RileyCornelius/LedCube-RGB/README.md

# LedCube
RGB Led Cube controlled by FastLED

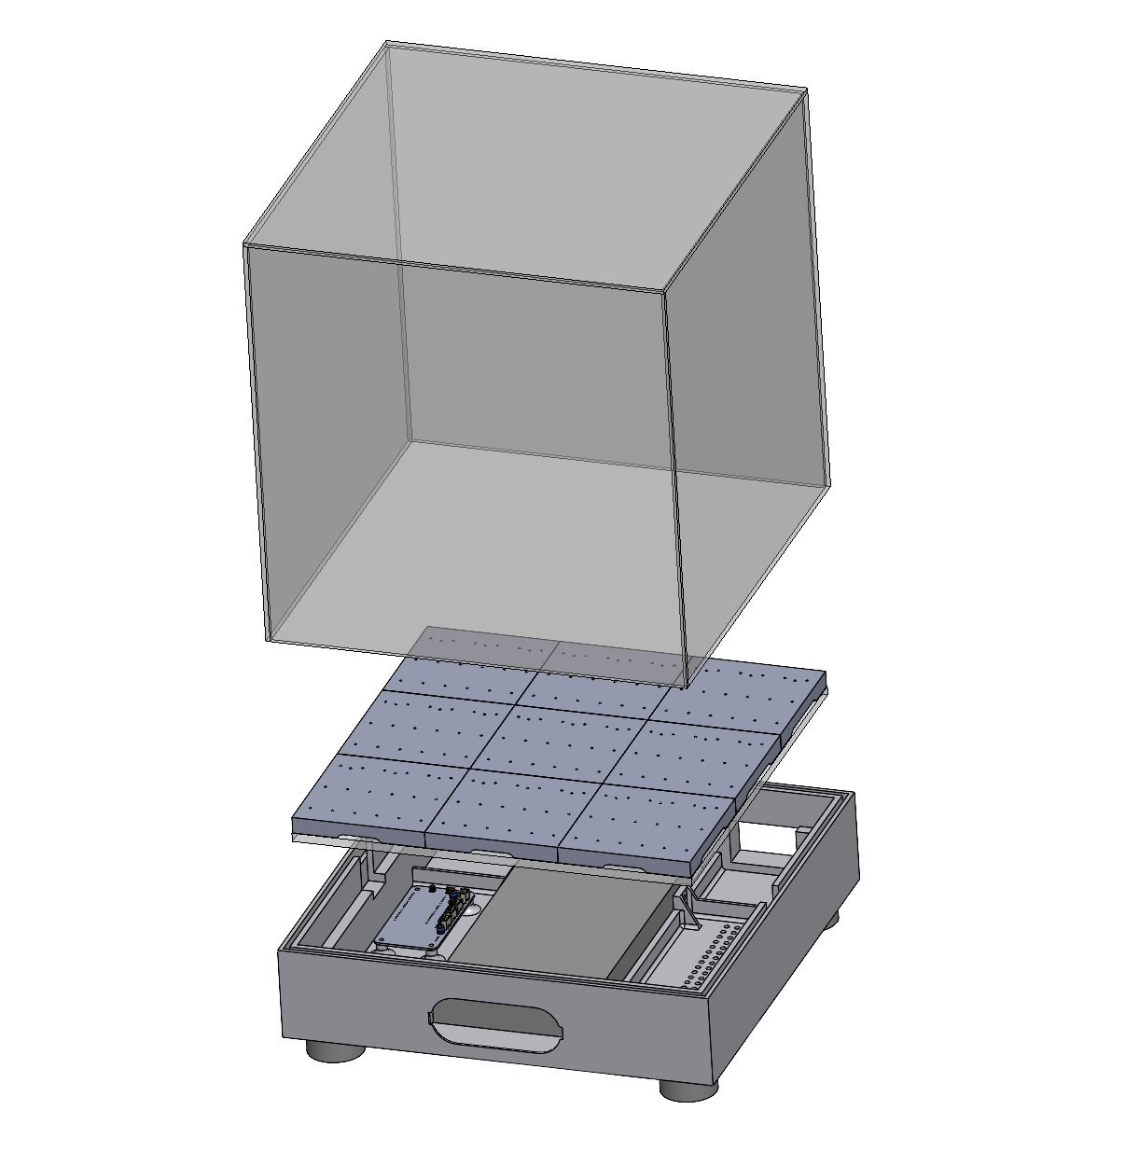
[picture p1: mechanical/Case-Parts-Assembly.png]
Drag Racing
