RileyCornelius/LedCube-RGB/electronics/block diagram/LedCube block diagram,.png

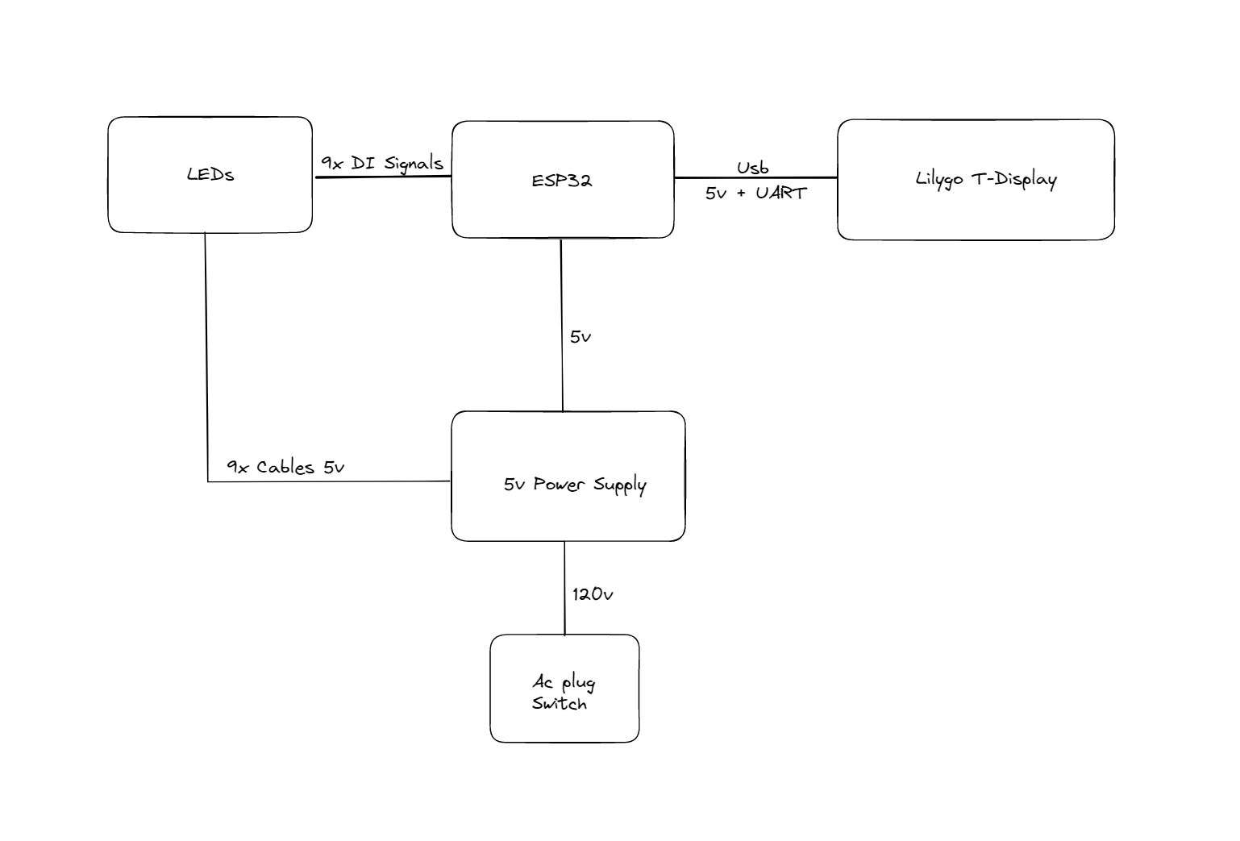
electronics/block diagram/LedCube block diagram,.png
