RileyCornelius/LedCube-RGB/electronics/kicad/PCB.png

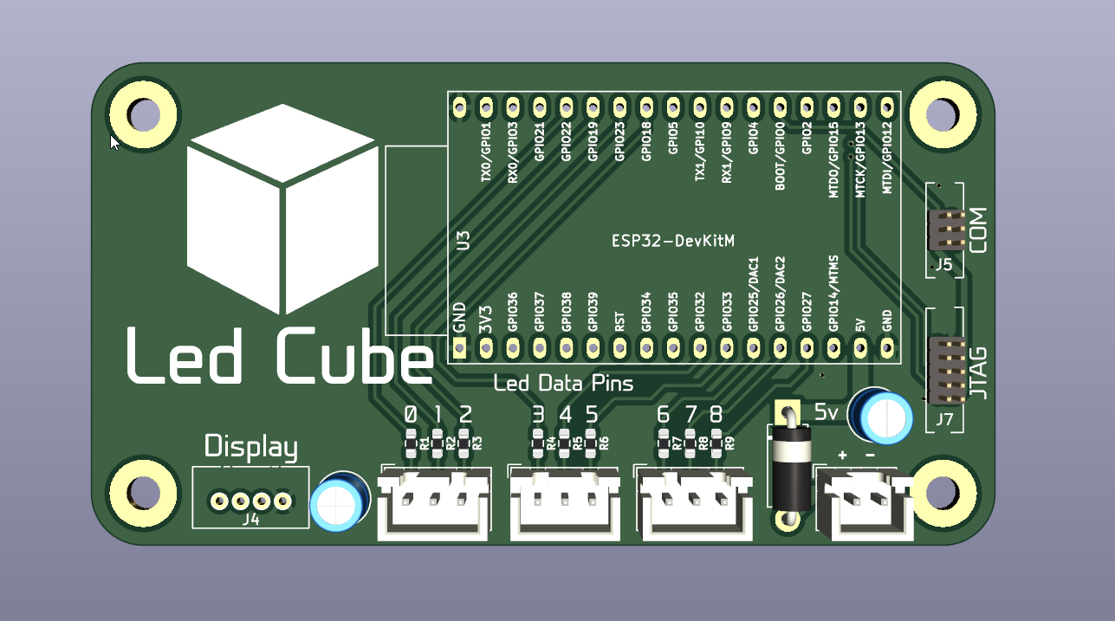
electronics/kicad/PCB.png
