RileyCornelius/LedCube-RGB/mechanical/case/solidworks/Case Full.SLDPRT

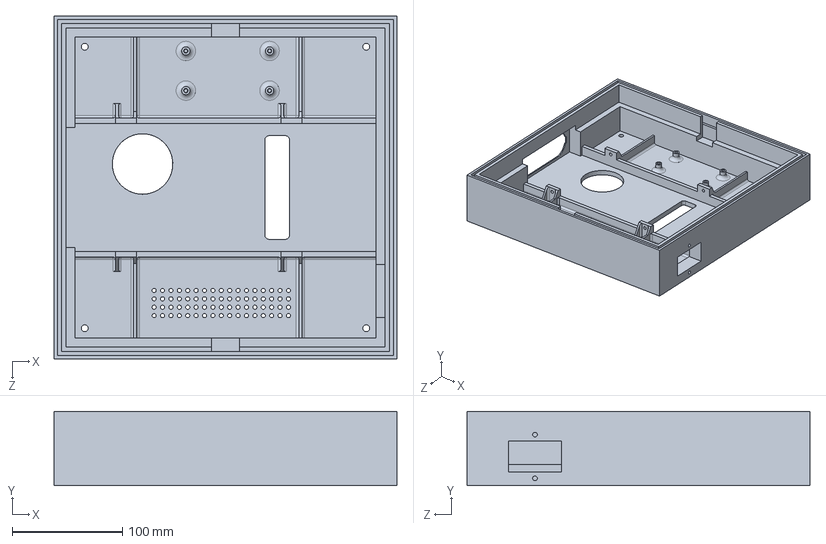
[picture p4: CAD file, 2023-04-22]
mechanical/case/solidworks/Case Full.SLDPRT
311.4 x 67.3 x 311.4 mm
