RileyCornelius/LedCube-RGB/mechanical/case/solidworks/Assem Led Base.SLDASM

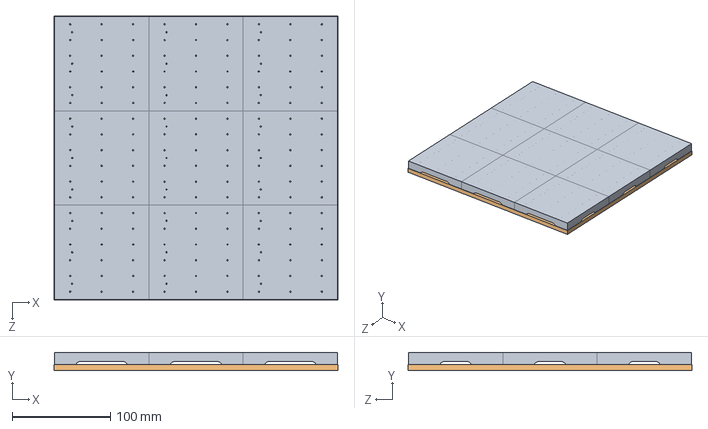
[picture p5: CAD file, 2023-04-22]
mechanical/case/solidworks/Assem Led Base.SLDASM
288.9 x 18.4 x 288.9 mm
Mounting Base x 9
Plexiglass11.4x11.4x1-4inch
