RileyCornelius/LedCube-RGB/mechanical/case/solidworks/Assem Corner Case.SLDASM

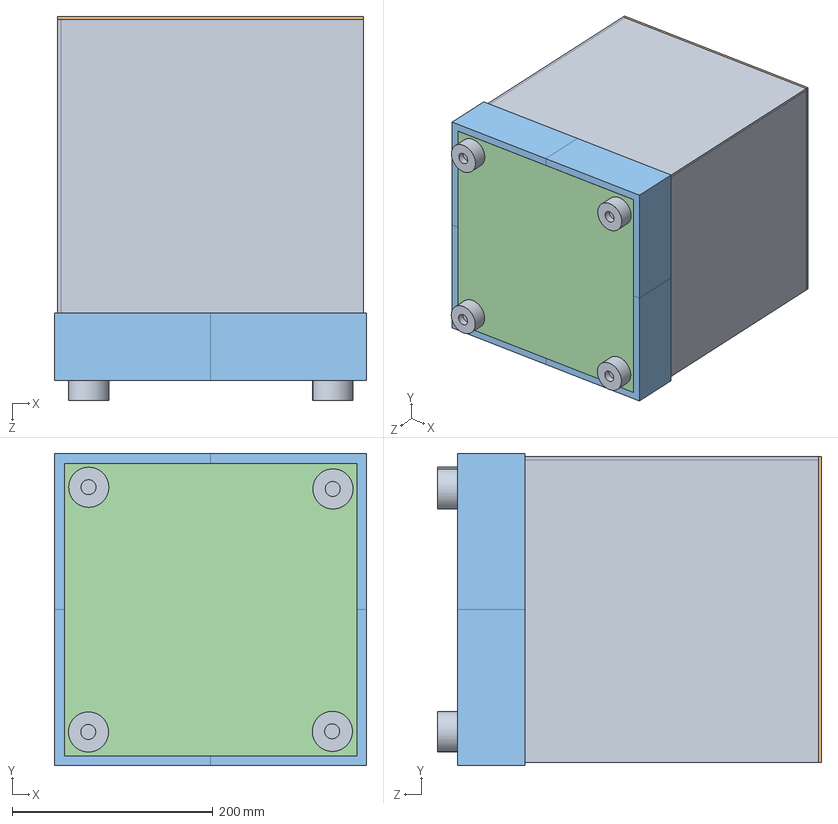
[picture p6: CAD file, 2023-04-22]
mechanical/case/solidworks/Assem Corner Case.SLDASM
311.4 x 311.4 x 382.7 mm
Plexiglass12x12x1-8inch
Plexiglass12x11 7-8x1-8inch x 4
Case Corner x 4
Plexiglass11.5x11.5x1-4inch
Plexiglass11.4x11.4x1-4inch
Mounting Base x 9
LED Height 1x11 1-2x1-4inch
Power Supply
Feet x 4
