RileyCornelius/LedCube-RGB/mechanical/case/solidworks/Assem Full Case.SLDASM

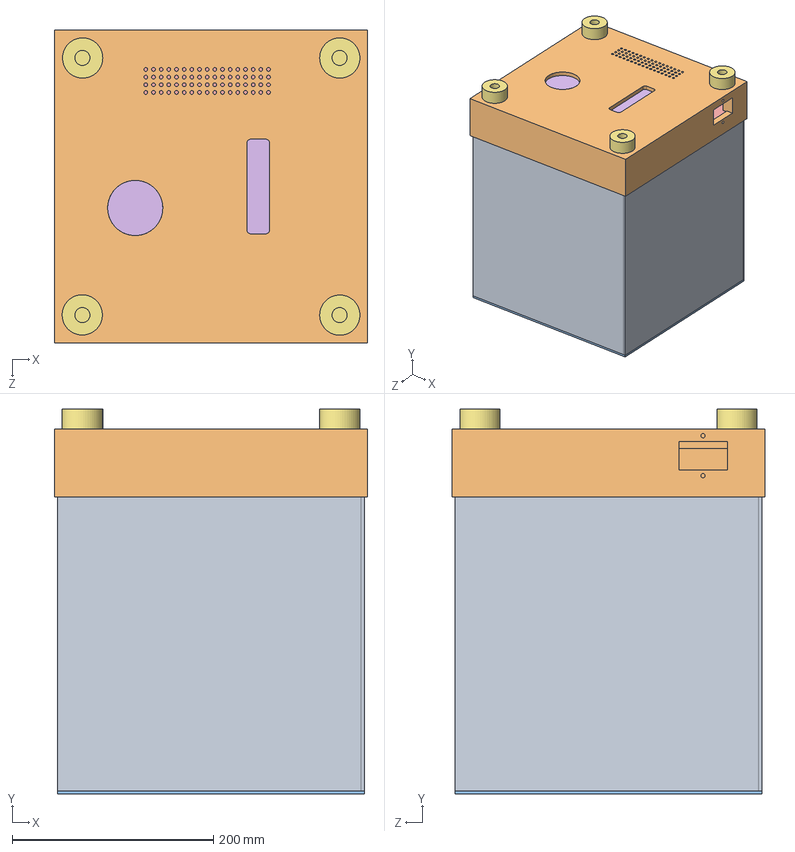
[picture p7: CAD file, 2023-04-22]
mechanical/case/solidworks/Assem Full Case.SLDASM
311.4 x 382.6 x 311.4 mm
Case Full
Plexiglass12x12x1-8inch
Plexiglass12x11 7-8x1-8inch x 4
Mounting Base x 9
Plexiglass11.4x11.4x1-4inch
Power Supply
Feet x 4
SOLID.step x 2
SOLID-0.step x 9
SOLID-1.step
SOLID-2.step x 3
SOLID-3.step
SOLID-4.step
SOLID-5.step
_autosave-LedCube PCB.step
