RileyCornelius/LedCube-RGB/mechanical/case/solidworks/Assem Plexiglass .SLDASM

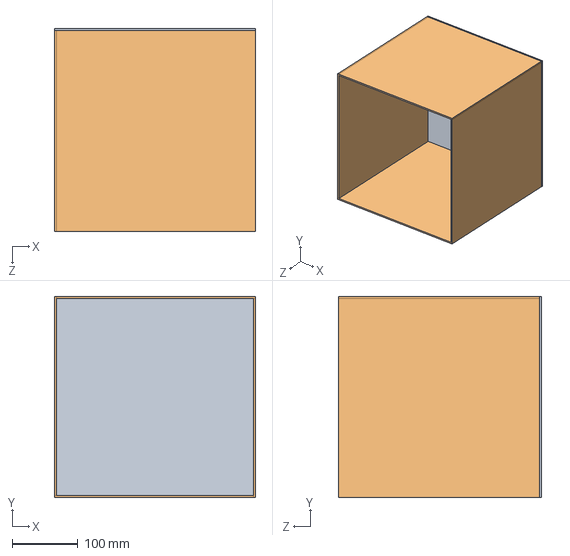
[picture p8: CAD file, 2023-04-22]
mechanical/case/solidworks/Assem Plexiglass .SLDASM
304.8 x 304.8 x 308.0 mm
Plexiglass12x12x1-8inch
Plexiglass12x11 7-8x1-8inch x 4
