RileyCornelius/LedCube-RGB/mechanical/accessories/solidworks/Jig Bottom B.SLDPRT

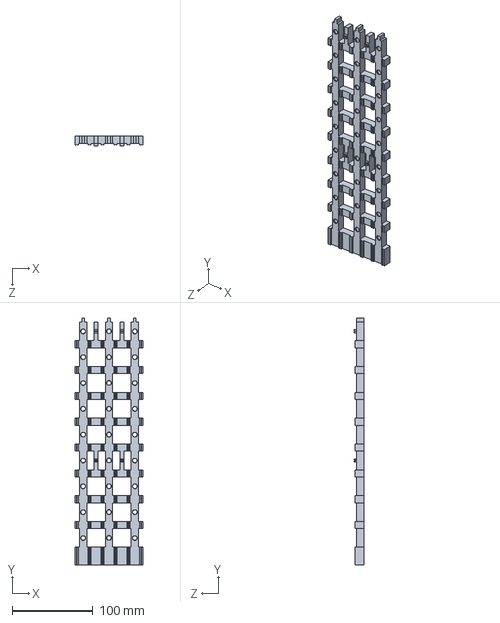
[picture p9: CAD file, 2023-03-17]
mechanical/accessories/solidworks/Jig Bottom B.SLDPRT
84.0 x 306.0 x 11.9 mm
