RileyCornelius/LedCube-RGB/mechanical/accessories/stl/Clip.stl

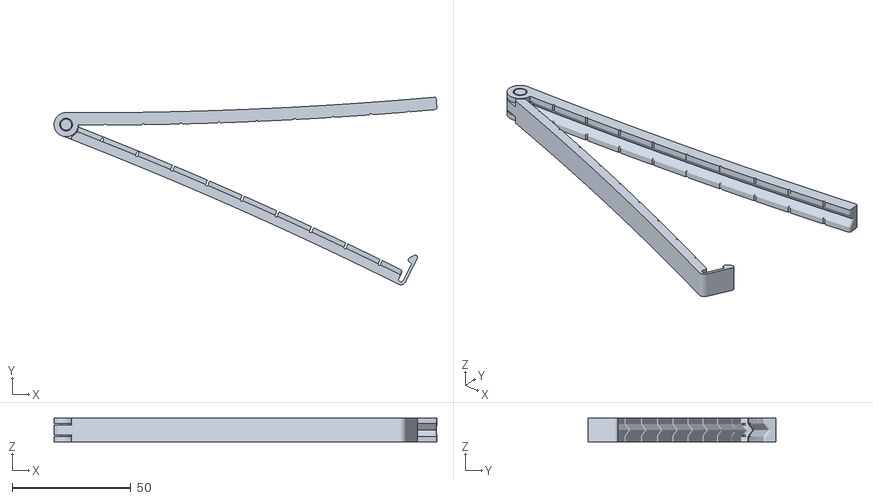
[picture p10: CAD file, 2023-03-17]
mechanical/accessories/stl/Clip.stl
161.5 x 79.1 x 10.0
