RileyCornelius/LedCube-RGB/mechanical/case/stl/display-front-panel.stl

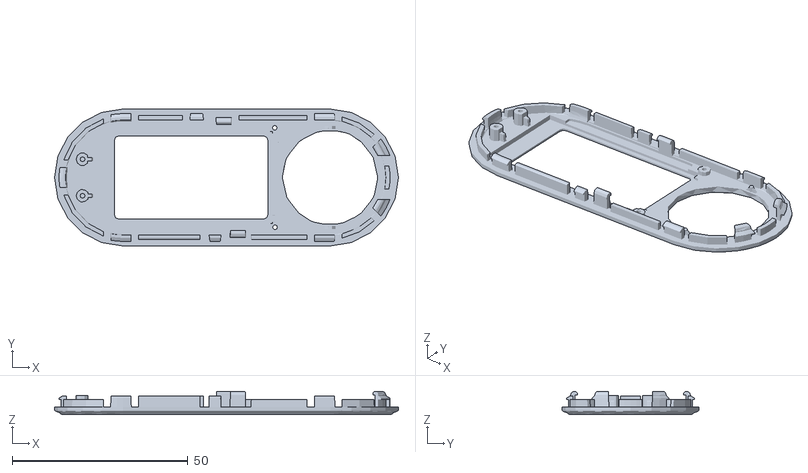
[picture p11: CAD file, 2023-03-17]
mechanical/case/stl/display-front-panel.stl
98.0 x 39.0 x 6.60
