RileyCornelius/LedCube-RGB/mechanical/accessories/stl/BendBox.stl

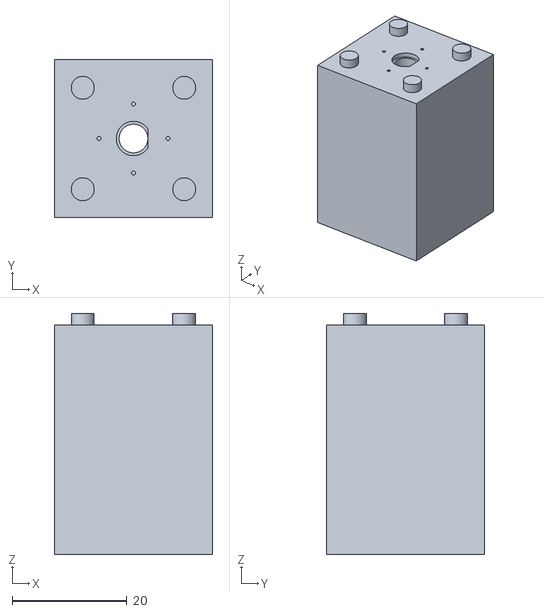
[picture p12: CAD file, 2023-03-17]
mechanical/accessories/stl/BendBox.stl
27.6 x 27.6 x 42.0
