RileyCornelius/LedCube-RGB/mechanical/case/solidworks/Mounting Base.SLDPRT

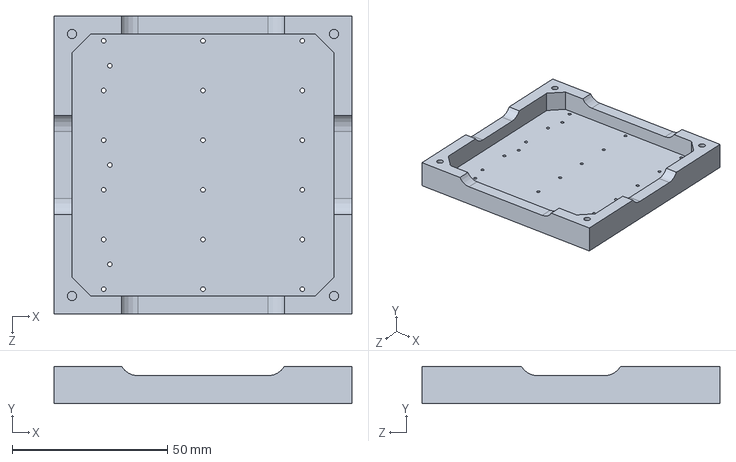
[picture p13: CAD file, 2023-04-22]
mechanical/case/solidworks/Mounting Base.SLDPRT
96.0 x 12.0 x 96.0 mm
