RileyCornelius/LedCube-RGB/mechanical/accessories/stl/BendBox Lid Thicker.stl

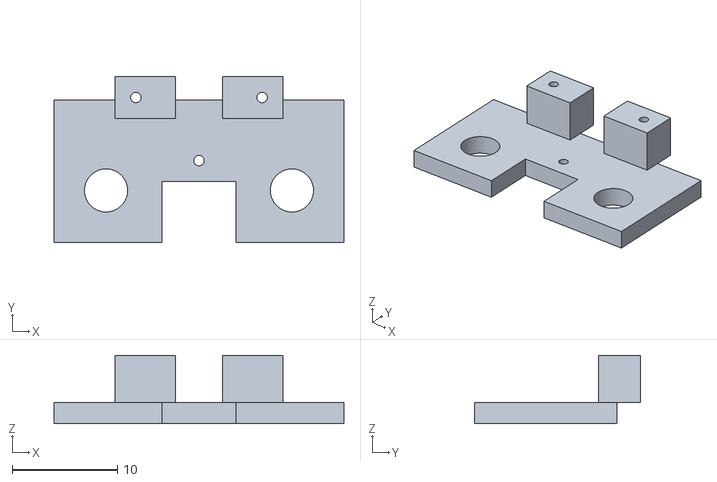
[picture p14: CAD file, 2023-03-17]
mechanical/accessories/stl/BendBox Lid Thicker.stl
27.6 x 15.8 x 6.50
