RileyCornelius/LedCube-RGB/mechanical/accessories/stl/BendBox Lid Flat.stl

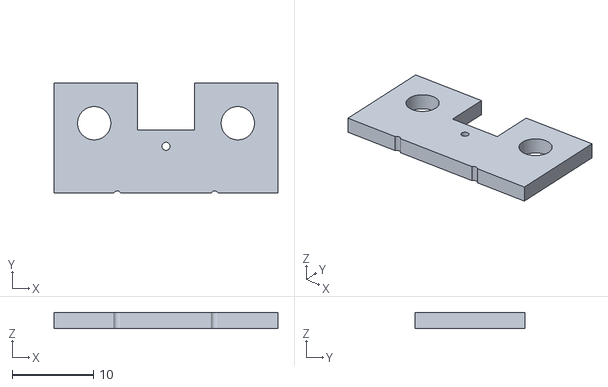
[picture p15: CAD file, 2023-03-17]
mechanical/accessories/stl/BendBox Lid Flat.stl
27.6 x 13.5 x 2.00
