RileyCornelius/LedCube-RGB/mechanical/case/solidworks/Power Supply.SLDPRT

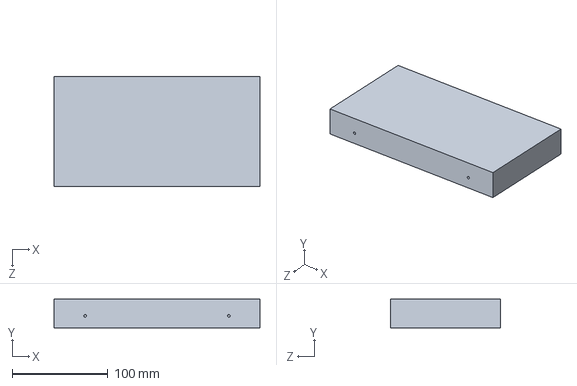
[picture p16: CAD file, 2023-04-22]
mechanical/case/solidworks/Power Supply.SLDPRT
215.0 x 30.0 x 115.0 mm
