RileyCornelius/LedCube-RGB/mechanical/case/solidworks/screen mount.SLDPRT

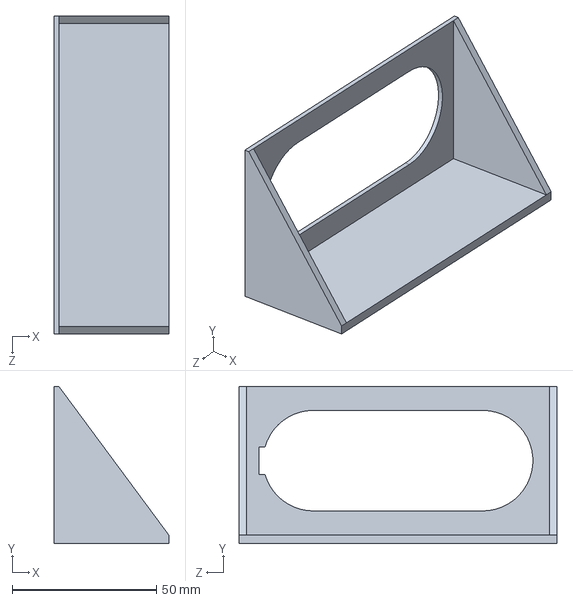
[picture p17: CAD file, 2023-04-22]
mechanical/case/solidworks/screen mount.SLDPRT
39.7 x 54.5 x 110.1 mm
