RileyCornelius/LedCube-RGB/mechanical/case/solidworks/Plexiglass11.4x11.4x1-4inch.SLDPRT

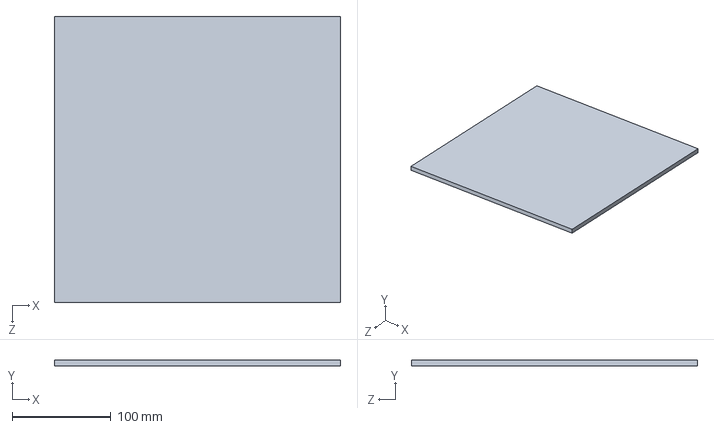
[picture p18: CAD file, 2023-04-22]
mechanical/case/solidworks/Plexiglass11.4x11.4x1-4inch.SLDPRT
288.9 x 6.36 x 288.9 mm
