RileyCornelius/LedCube-RGB/mechanical/case/solidworks/LedCubePCB.step

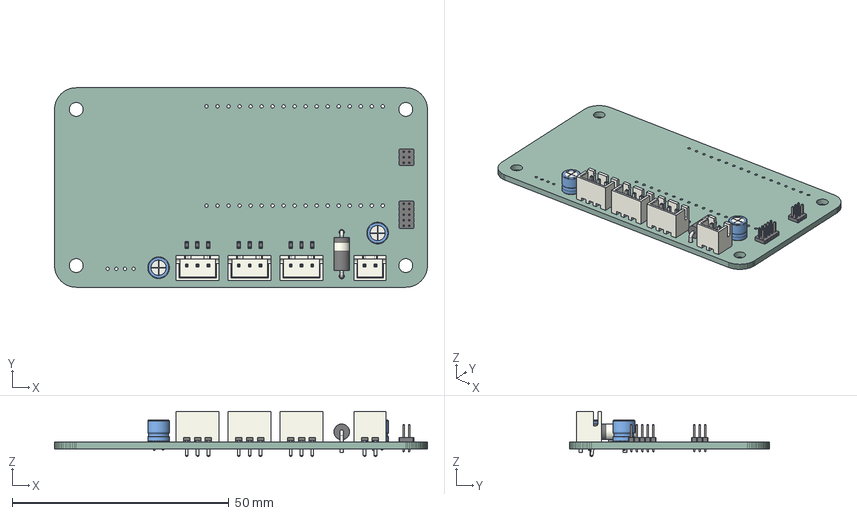
[picture p19: CAD file, 2023-04-21]
mechanical/case/solidworks/LedCubePCB.step
86.0 x 46.0 x 10.4 mm
_autosave-LedCube PCB
