RileyCornelius/LedCube-RGB/mechanical/case/solidworks/Case Corner.SLDPRT

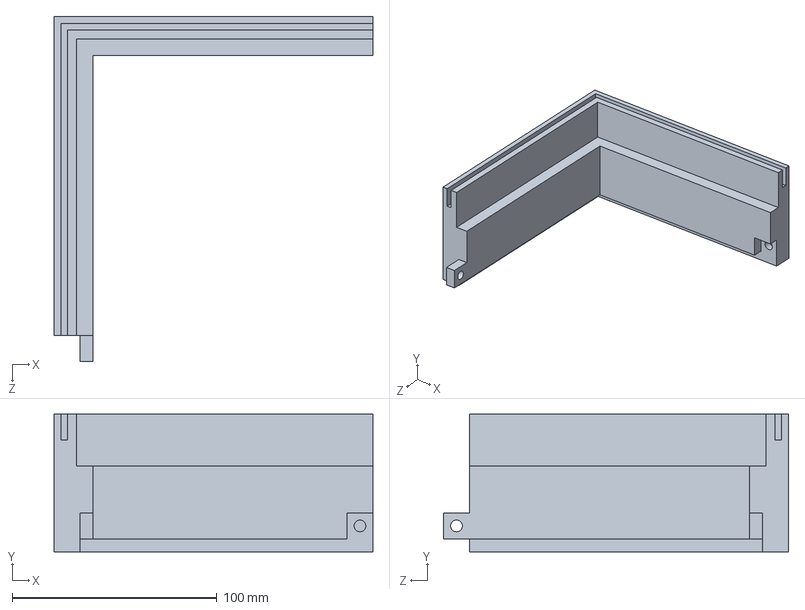
[picture p20: CAD file, 2023-04-04]
mechanical/case/solidworks/Case Corner.SLDPRT
155.7 x 67.3 x 168.4 mm
