RileyCornelius/LedCube-RGB/mechanical/case/solidworks/Plexiglass12x12x1-8inch.SLDPRT

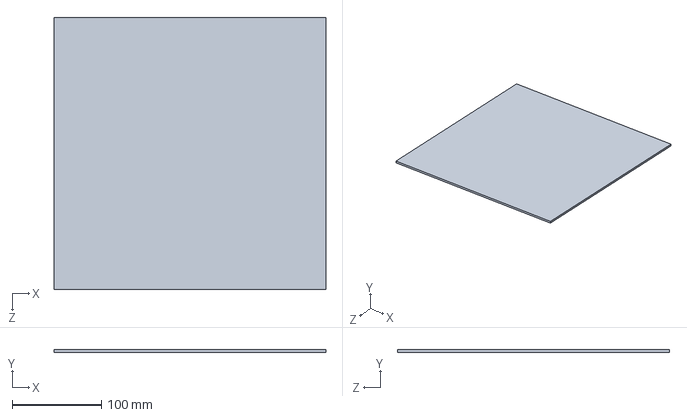
[picture p21: CAD file, 2023-03-17]
mechanical/case/solidworks/Plexiglass12x12x1-8inch.SLDPRT
304.8 x 3.17 x 304.8 mm
