RileyCornelius/LedCube-RGB/mechanical/case/solidworks/LED Height 1x11 1-2x1-4inch.SLDPRT

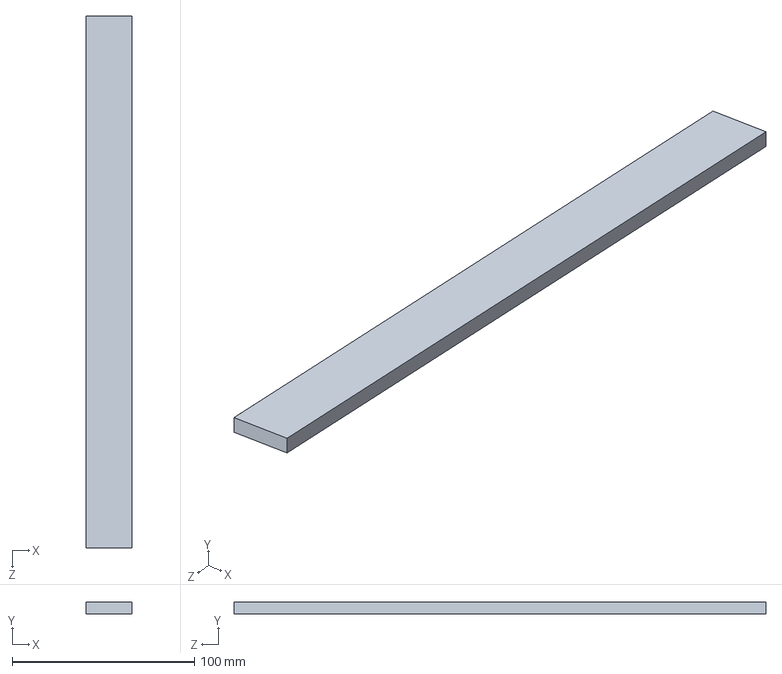
[picture p22: CAD file, 2023-03-17]
mechanical/case/solidworks/LED Height 1x11 1-2x1-4inch.SLDPRT
25.3 x 6.36 x 292.3 mm
