RileyCornelius/LedCube-RGB/mechanical/case/solidworks/Plexiglass11.5x11.5x1-4inch.SLDPRT

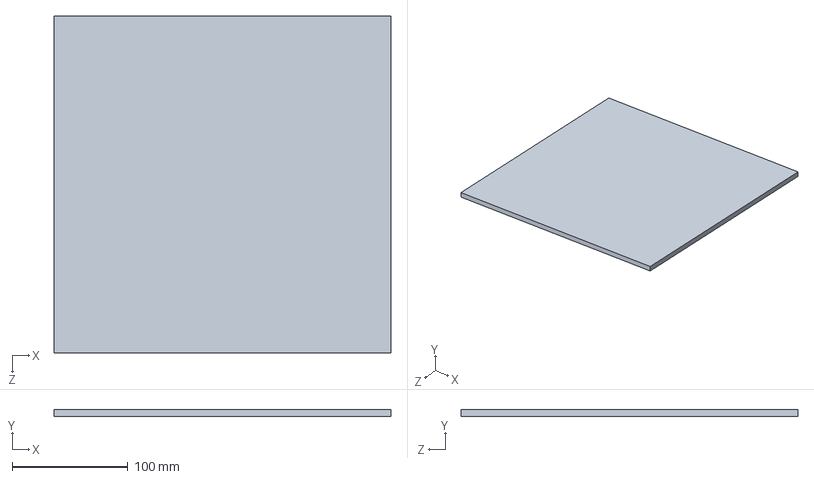
[picture p23: CAD file, 2023-03-17]
mechanical/case/solidworks/Plexiglass11.5x11.5x1-4inch.SLDPRT
291.7 x 6.36 x 291.7 mm
