RileyCornelius/LedCube-RGB/mechanical/case/solidworks/Feet Small.SLDPRT

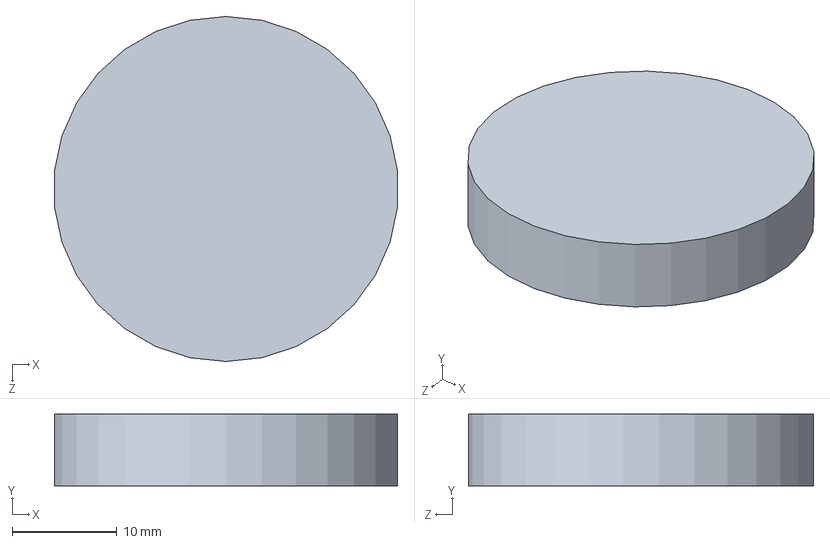
[picture p24: CAD file, 2023-03-17]
mechanical/case/solidworks/Feet Small.SLDPRT
32.8 x 6.86 x 33.0 mm
