RileyCornelius/LedCube-RGB/mechanical/case/solidworks/Feet.SLDPRT

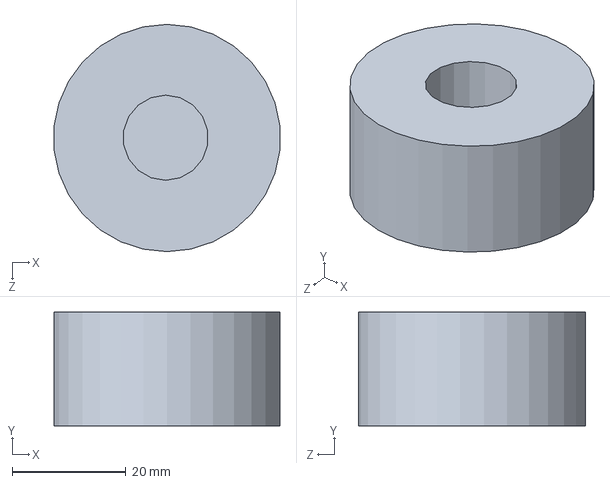
[picture p25: CAD file, 2023-03-17]
mechanical/case/solidworks/Feet.SLDPRT
39.8 x 20.0 x 40.0 mm
