RileyCornelius/LedCube-RGB/(list of files, cad)

Other CAD files:
mechanical/accessories/solidworks/Jig Bottom A.SLDPRT
mechanical/case/solidworks/Plexiglass12x11 7-8x1-8inch.SLDPRT
mechanical/case/stl/Case Full.STL
