RileyCornelius/LedCube-RGB/mechanical/Case-Assembly.png

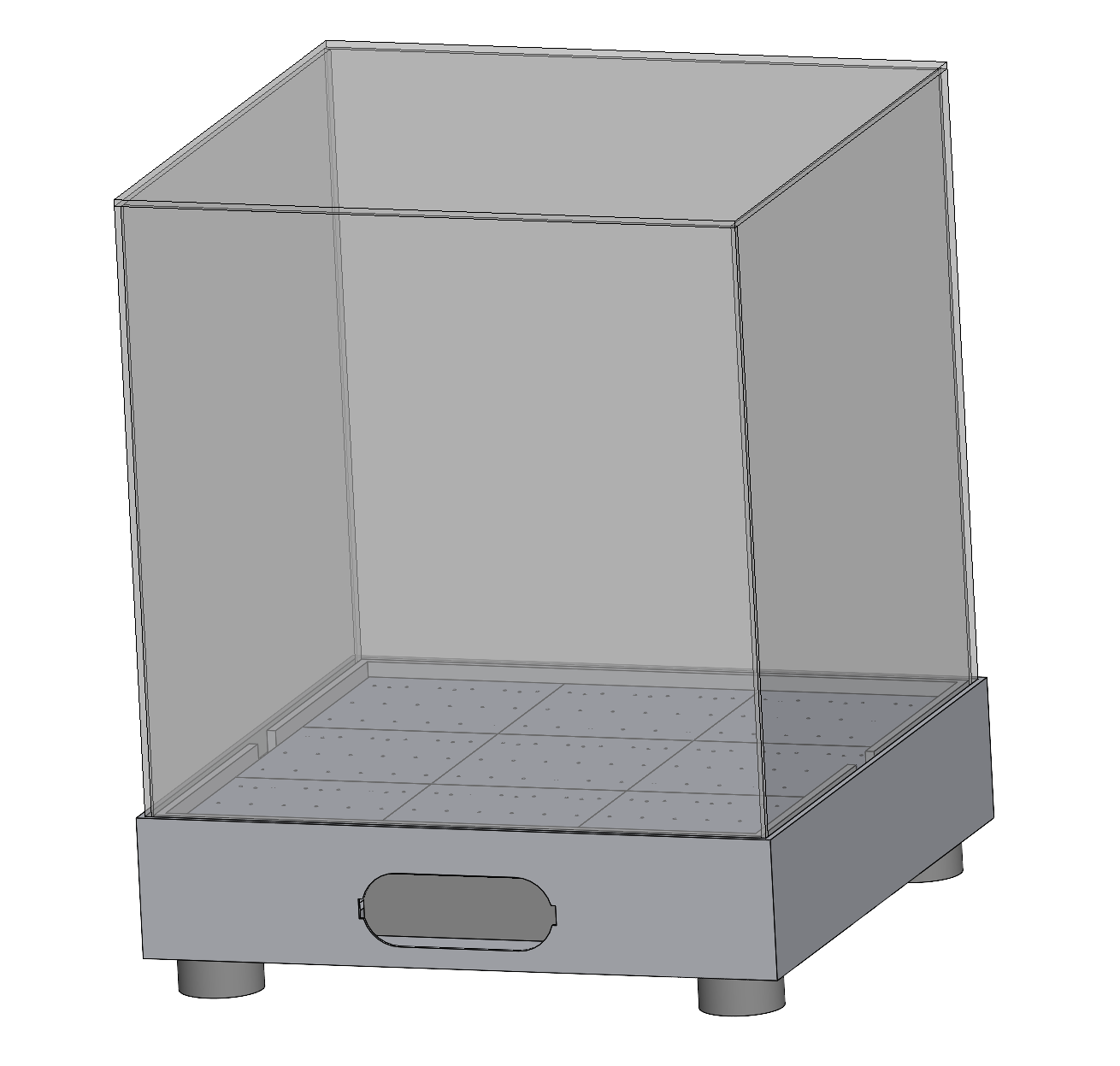
mechanical/Case-Assembly.png
