RileyCornelius/LedCube-RGB/mechanical/Case-Inside-Assembly.png

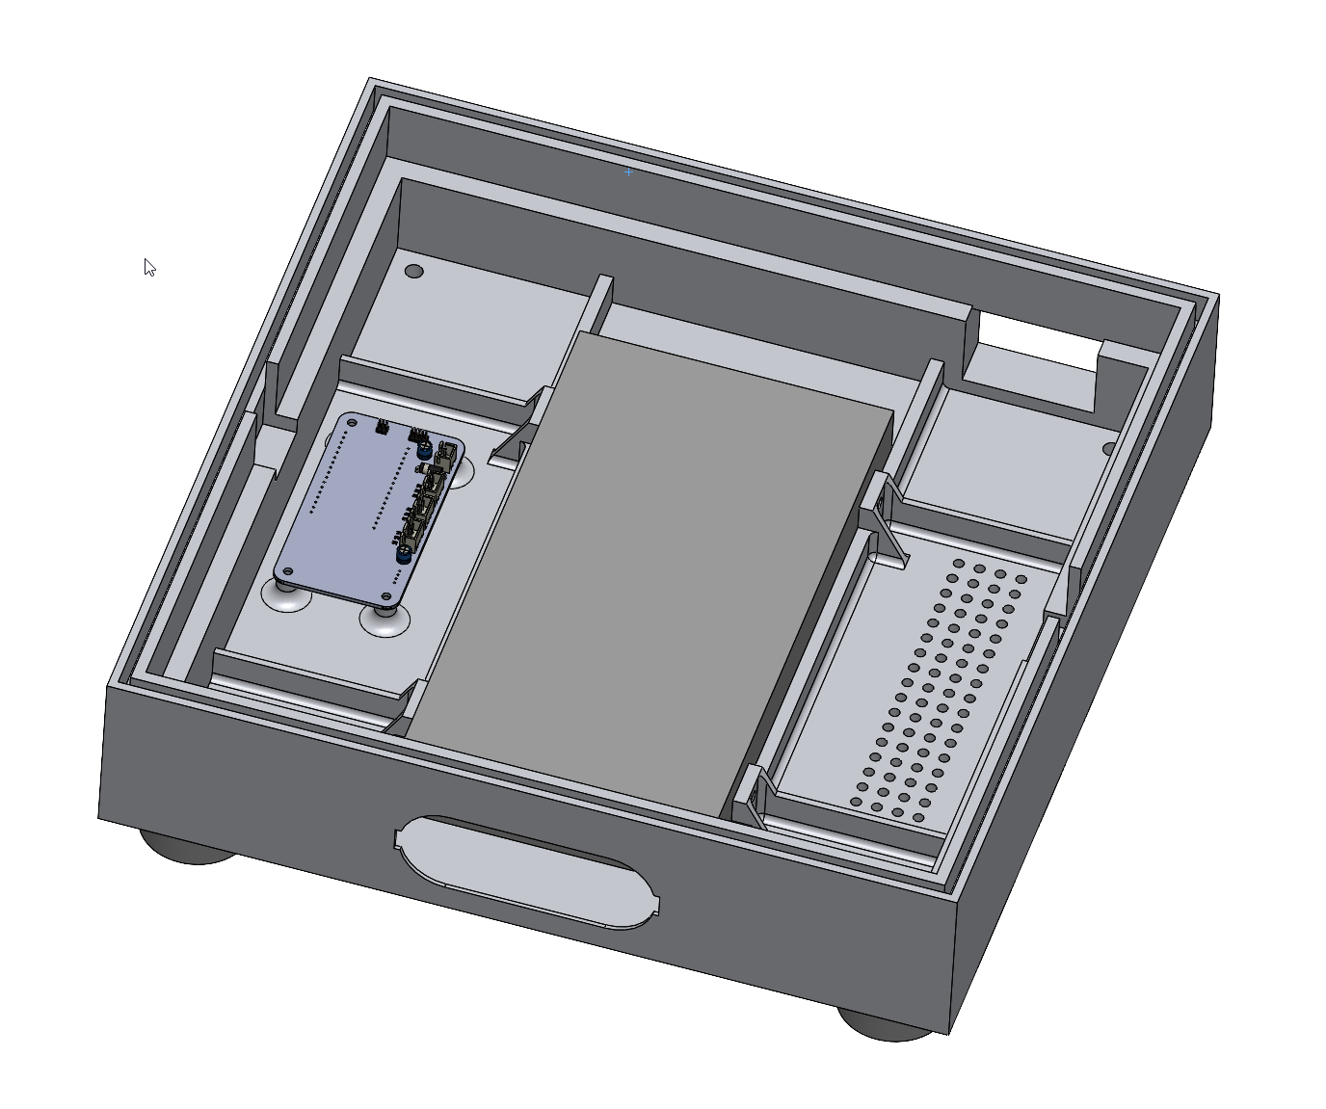
mechanical/Case-Inside-Assembly.png
