RileyCornelius/LedCube-RGB/electronics/schematic/LedCube Schematic.pdf

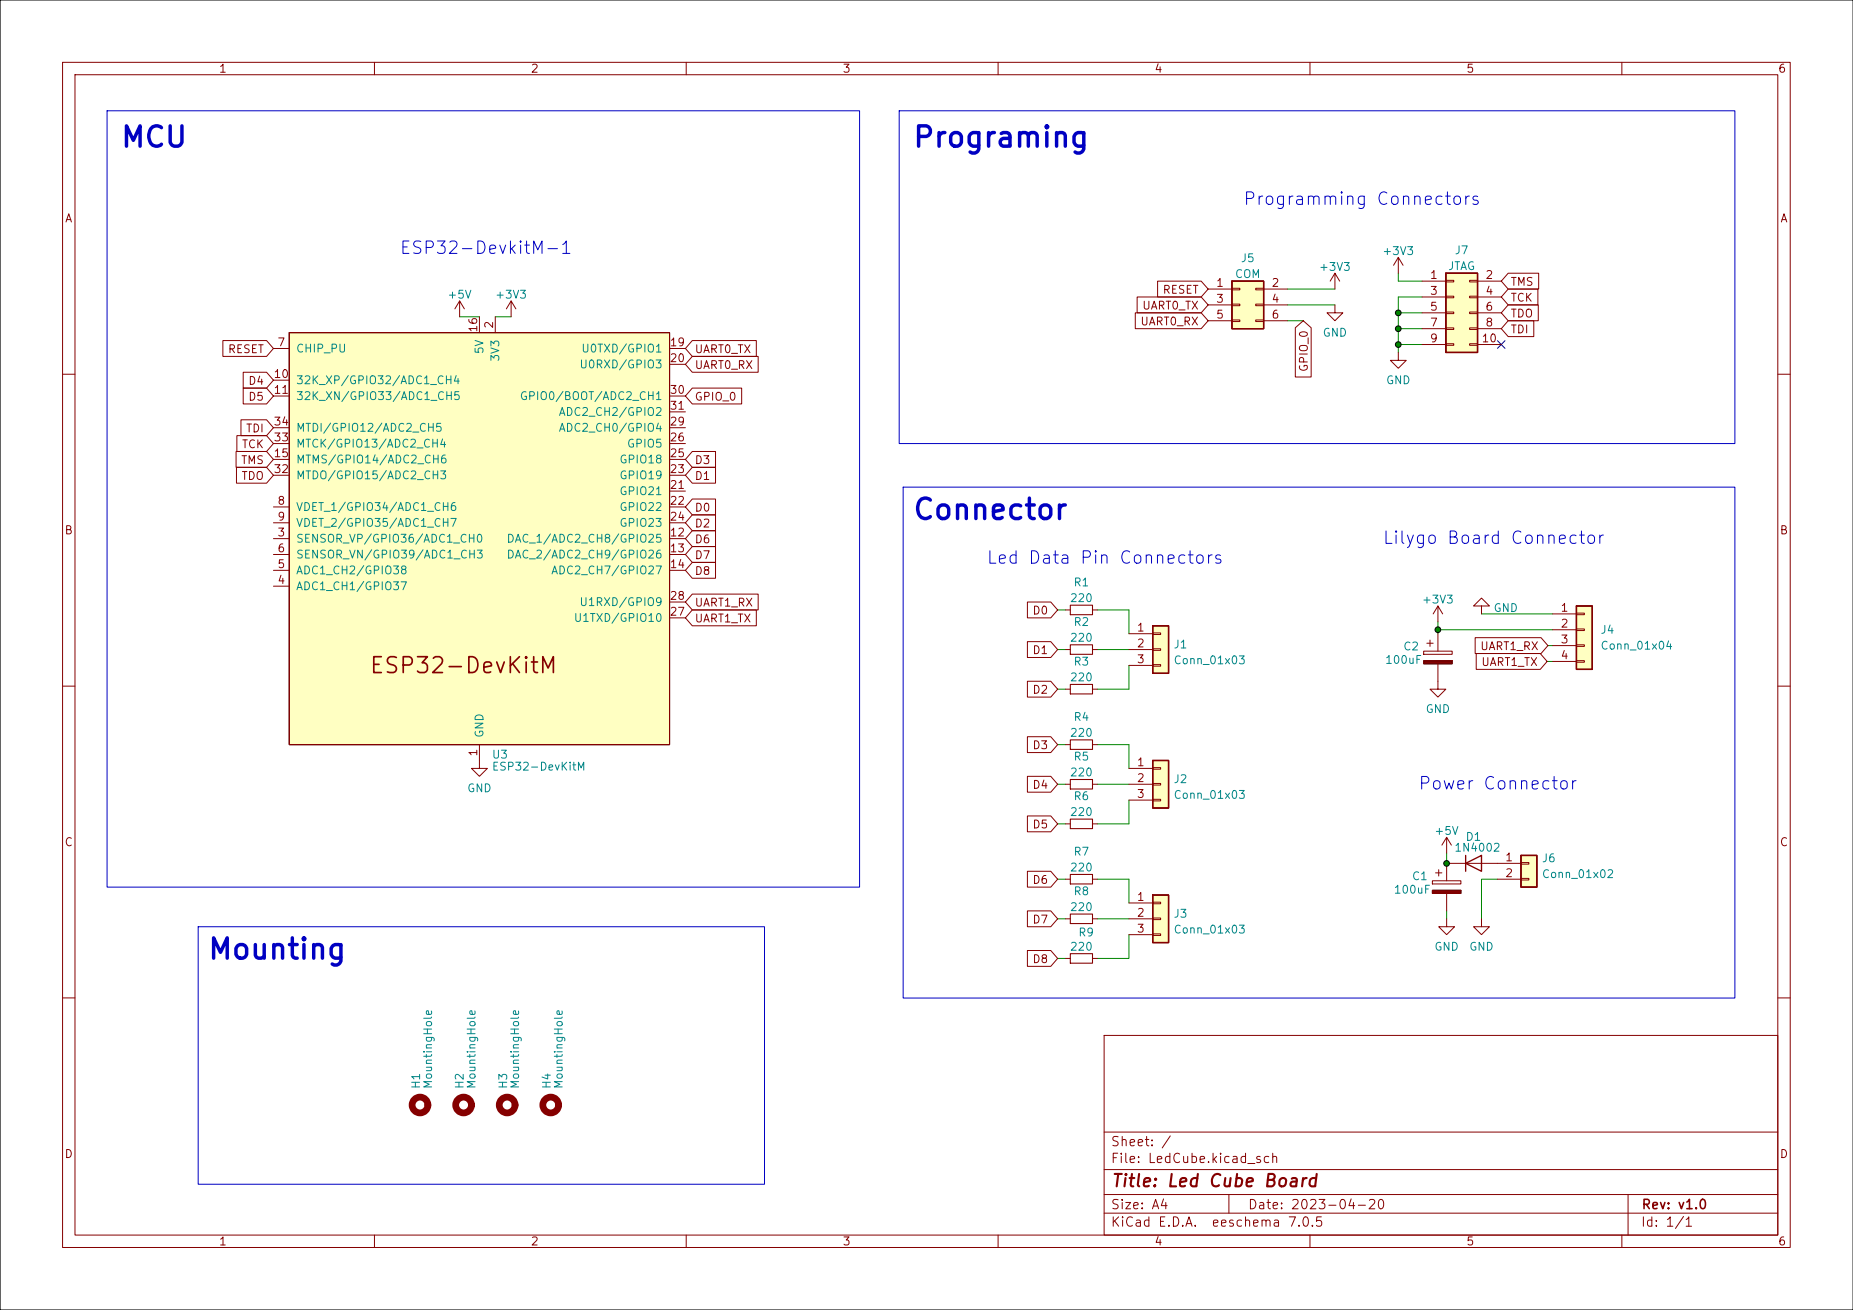
[picture p28: page 1]
