RileyCornelius/LedCube-RGB/electronics/kicad/LedCube/LedCube.kicad_pcb

## KiCad design electronics/kicad/LedCube/LedCube.kicad_pcb (2023-05-06)

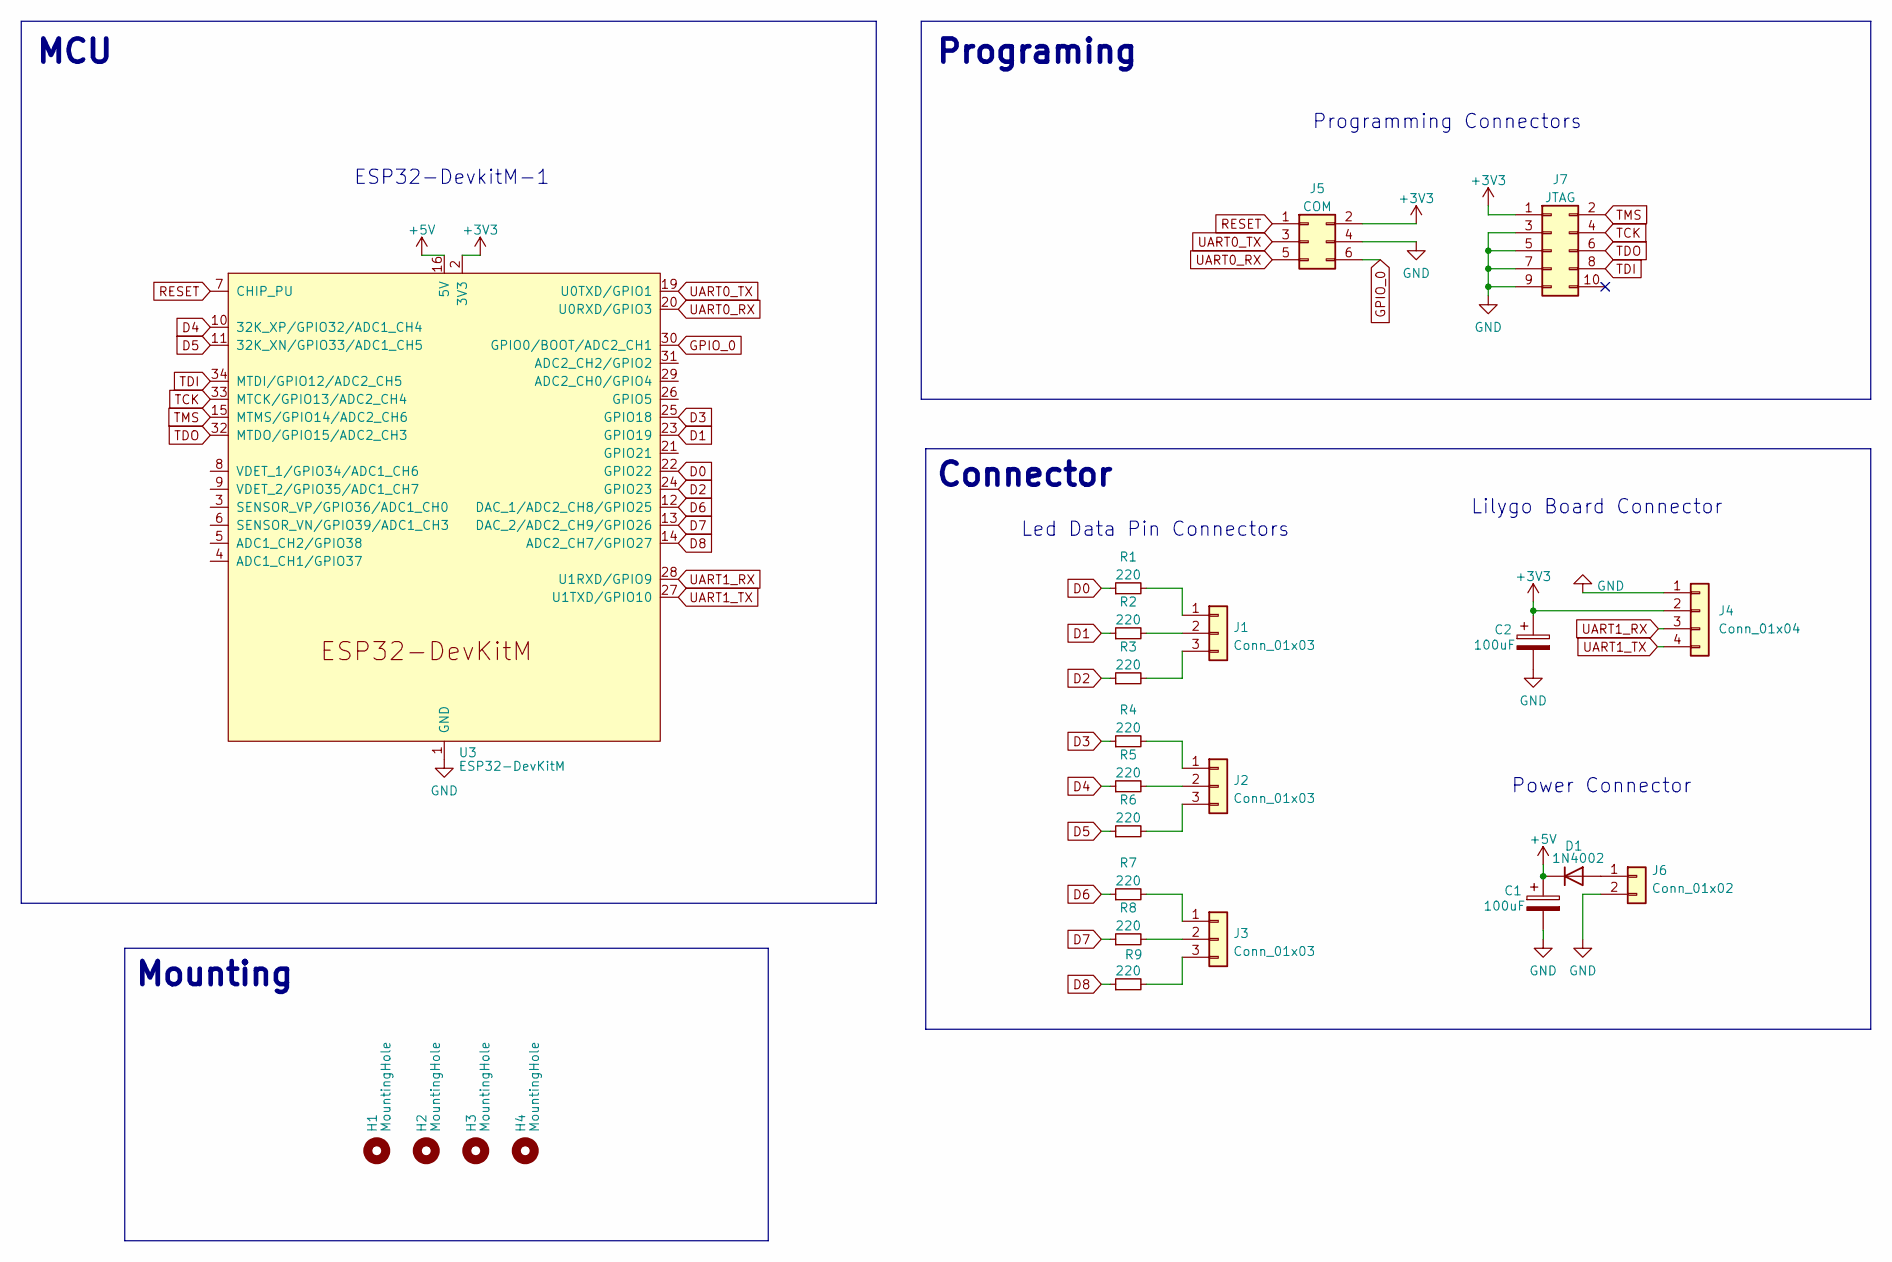
[picture p29: schematic LedCube.kicad_sch, Led Cube Board]

Parts:
C1, C2: 100uF; C_Radial_D5.0mm_H5.0mm_P2.00mm
D1: 1N4002; D_DO-15_P10.16mm_Horizontal
H1, H2, H3, H4: MountingHole; MountingHole_3.2mm_M3_Pad
J1, J2, J3: Conn_01x03; JST_XH_B3B-XH-A_1x03_P2.50mm_Vertical
J4: Conn_01x04; Grove_1x04
J5: COM; ESP_PROG_COM; Manufacturer Part Number 20021511-00006T4LF; Digikey Part Number 20021511-00006T4LF-ND
J6: Conn_01x02; JST_XH_B2B-XH-A_1x02_P2.50mm_Vertical
J7: JTAG; ESP_PROG_JTAG; Manufacturer Part Number 3220-10-0100-00; Digikey Part Number 1175-1627-ND
R1, R2, R3, R4, R5, R6, R7, R8, R9: 220; R_0603_1608Metric_Pad0.98x0.95mm_HandSolder
U3: ESP32-DevKitM

Connections:
+3V3: C2.1, J4.2, J5.2, J7.1, U3.2 (3V3)
+5V: C1.1, D1.1 (K), U3.16 (5V)
D0: R1.1, U3.22 (GPIO22)
D1: R2.1, U3.23 (GPIO19)
D2: R3.1, U3.24 (GPIO23)
D3: R4.1, U3.25 (GPIO18)
D4: R5.1, U3.10 (32K_XP/GPIO32/ADC1_CH4)
D5: R6.1, U3.11 (32K_XN/GPIO33/ADC1_CH5)
D6: R7.1, U3.12 (DAC_1/ADC2_CH8/GPIO25)
D7: R8.1, U3.13 (DAC_2/ADC2_CH9/GPIO26)
D8: R9.1, U3.14 (ADC2_CH7/GPIO27)
GND: C1.2, C2.2, J4.1, J5.4, J6.2, J7.3, J7.5, J7.7, J7.9, U3.1 (GND), U3.17 (GND), U3.18 (GND)
GPIO_0: J5.6, U3.30 (GPIO0/BOOT/ADC2_CH1)
unnamed: D1.2 (A), J6.1
unnamed: J1.1, R1.2
unnamed: J1.2, R2.2
unnamed: J1.3, R3.2
unnamed: J2.1, R4.2
unnamed: J2.2, R5.2
unnamed: J2.3, R6.2
unnamed: J3.1, R7.2
unnamed: J3.2, R8.2
unnamed: J3.3, R9.2
RESET: J5.1, U3.7 (CHIP_PU)
TCK: J7.4, U3.33 (MTCK/GPIO13/ADC2_CH4)
TDI: J7.8, U3.34 (MTDI/GPIO12/ADC2_CH5)
TDO: J7.6, U3.32 (MTDO/GPIO15/ADC2_CH3)
TMS: J7.2, U3.15 (MTMS/GPIO14/ADC2_CH6)
UART0_RX: J5.5, U3.20 (U0RXD/GPIO3)
UART0_TX: J5.3, U3.19 (U0TXD/GPIO1)
UART1_RX: J4.3, U3.28 (U1RXD/GPIO9)
UART1_TX: J4.4, U3.27 (U1TXD/GPIO10)

Notes on the sheet:
ESP32-DevkitM-1
Programming Connectors
Programing
MCU
Connector
Mounting
Lilygo Board Connector
Power Connector
Led Data Pin Connectors

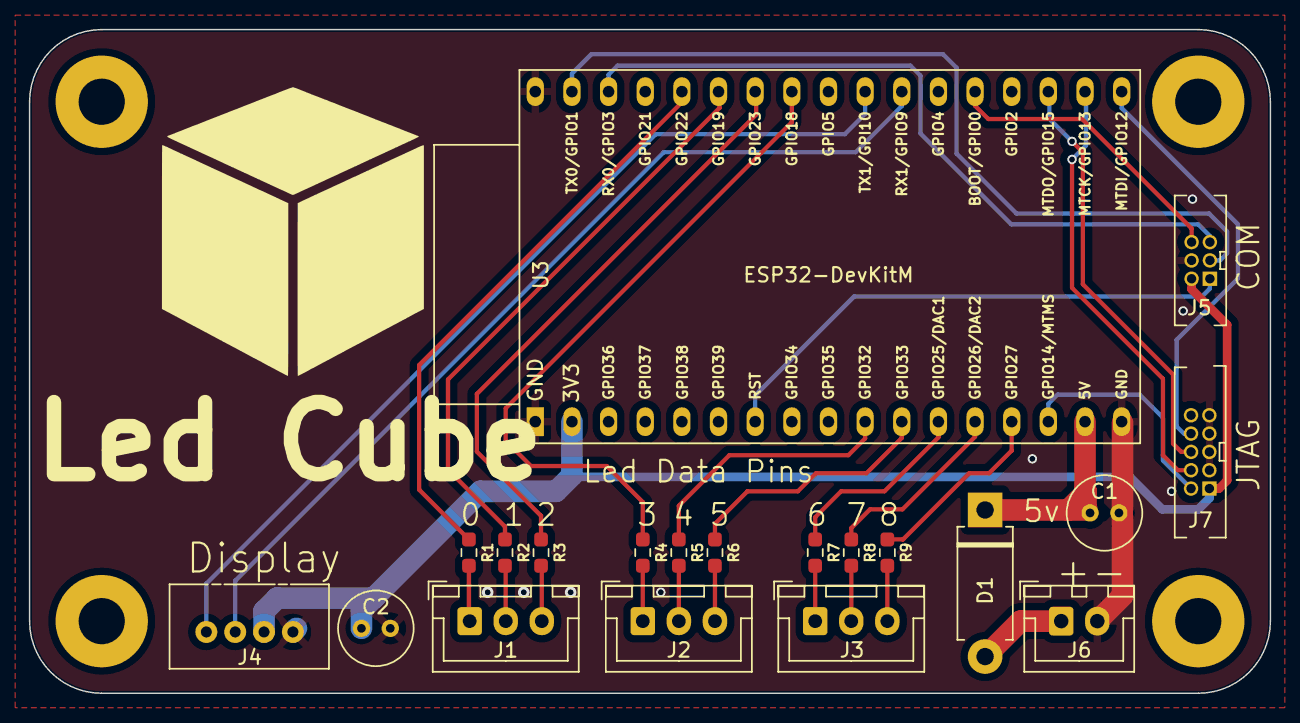
[picture p30: board LedCube.kicad_pcb from above]

Board: 2 copper layers, 86.0 x 46.0 mm, 24 parts (0 on the bottom side), 32 nets.
