RileyCornelius/LedCube-RGB/firmware/LedCube/src/Config/Pins.h

#pragma once

// Led Pins (390 ohm resistor on each pin)
#define PIN_LED_0 22
#define PIN_LED_1 19
#define PIN_LED_2 23
#define PIN_LED_3 18
#define PIN_LED_4 32
#define PIN_LED_5 33
#define PIN_LED_6 25
#define PIN_LED_7 26
#define PIN_LED_8 27
