RileyCornelius/LedCube-RGB/firmware/TowerTest/src/Config.h

// // Cube Defines
// #define CUBE_SIZE 2
// #define LED_COUNT (CUBE_SIZE * CUBE_SIZE * CUBE_SIZE)
// #define LED_TYPE PL9823
// #define LED_COLOR_ORDER RGB
// #define LED_BRIGHTNESS 255

// // Branches
// #define LED_BRANCHES 2
// #define LED_BRANCH_COUNT (LED_COUNT / LED_BRANCHES)

// // Led Pins (150 ohm resistor on each pin)
// #define LED_PIN 5
// #define LED_1_PIN 18

// // Button Pins
// #define NEXT_BTN_PIN 19
// #define PREV_BTN_PIN 21
// #define PAUSE_BTN_PIN 22

// Cube Defines
// #define CUBE_SIZE 9
// #define ROW_SIZE 9
// #define COLUMN_SIZE 3
#define CUBE_SIZE 2
#define ROW_SIZE 2
#define COLUMN_SIZE 2
#define LED_COUNT (ROW_SIZE * COLUMN_SIZE)
#define LED_TYPE PL9823
#define LED_COLOR_ORDER RGB
#define LED_PIN 5
// #define LED_PIN 2
