RileyCornelius/LedCube-RGB/firmware/LedCube-T-Embed-Display/src/ui/lv_setup.cpp

#include <lvgl.h>          // https://github.com/lvgl/lvgl
#include <TFT_eSPI.h>      // https://github.com/Bodmer/TFT_eSPI
#include <RotaryEncoder.h> // https://github.com/mathertel/RotaryEncoder
#include <OneButton.h>     // https://github.com/mathertel/OneButton
#include <APA102.h>        // https://github.com/pololu/apa102-arduino
#include <SimpleTimer.h>
#include "config.h"
#include "com/cube_com.h"
#include "ui/ui.h"

/* Screen dimensions */
#define LV_SCREEN_WIDTH 320
#define LV_SCREEN_HEIGHT 170
#define LV_BUF_SIZE (LV_SCREEN_WIDTH * LV_SCREEN_HEIGHT)

/* Input events bit masks */
#define LV_BUTTON bit(0)
#define LV_ENCODER_CW bit(1)
#define LV_ENCODER_CCW bit(2)
#define LV_ENCODER_LED_CW bit(3)
#define LV_ENCODER_LED_CCW bit(4)

EventGroupHandle_t lv_input_event;
RotaryEncoder encoder(PIN_ENCODE_A, PIN_ENCODE_B, RotaryEncoder::LatchMode::TWO03);
OneButton button(PIN_ENCODE_BTN, true);
TFT_eSPI tft = TFT_eSPI(LV_SCREEN_HEIGHT, LV_SCREEN_WIDTH);

bool screenFocus = false;

/* Display rendering callback */
static void lv_disp_flush(lv_disp_drv_t *disp, const lv_area_t *area, lv_color_t *color_p)
{
    uint32_t w = (area->x2 - area->x1 + 1);
    uint32_t h = (area->y2 - area->y1 + 1);
    tft.setAddrWindow(area->x1, area->y1, w, h);
    tft.pushColors((uint16_t *)&color_p->full, w * h);
    lv_disp_flush_ready(disp);
}

/* Read input events callback */
static void lv_encoder_read(lv_indev_drv_t *indev_drv, lv_indev_data_t *data)
{
    EventGroupHandle_t *lv_input_event = (EventGroupHandle_t *)indev_drv->user_data;
    EventBits_t bit = xEventGroupGetBits(lv_input_event);
    data->state = LV_INDEV_STATE_RELEASED;
    if (bit & LV_BUTTON)
    {
        // Serial.println("Button pressed");
        xEventGroupClearBits(lv_input_event, LV_BUTTON);
        data->state = LV_INDEV_STATE_PR;
    }
    else if (bit & LV_ENCODER_CW)
    {
        // Serial.println("Encoder CW");
        xEventGroupClearBits(lv_input_event, LV_ENCODER_CW);
        data->enc_diff = 1;
    }
    else if (bit & LV_ENCODER_CCW)
    {
        // Serial.println("Encoder CCW");
        xEventGroupClearBits(lv_input_event, LV_ENCODER_CCW);
        data->enc_diff = -1;
    }
}

/* Read encoder direction */
static void encoder_read()
{
    static Timer debounceTimer(200);
    RotaryEncoder::Direction dir = encoder.getDirection();

    if (screenFocus)
    {
        if (dir != RotaryEncoder::Direction::NOROTATION)
        {
            if (dir != RotaryEncoder::Direction::CLOCKWISE)
            {
                xEventGroupSetBits(lv_input_event, LV_ENCODER_CW);
                // xEventGroupSetBits(lv_input_event, LV_ENCODER_LED_CW);
            }
            else
            {
                xEventGroupSetBits(lv_input_event, LV_ENCODER_CCW);
                // xEventGroupSetBits(lv_input_event, LV_ENCODER_LED_CCW);
            }
        }
    }
    else
    {
        if (dir != RotaryEncoder::Direction::NOROTATION && debounceTimer.getElapsed() > debounceTimer.getPeriod())
        {
            debounceTimer.reset();

            if (dir != RotaryEncoder::Direction::CLOCKWISE)
            {
                writeDisplayCommand(CommandNext);
            }
            else
            {
                writeDisplayCommand(CommandPrevious);
            }
        }
    }
}

static void button_clicked(void *param)
{
    static bool playing = false;
    static Timer debounceTimer(200);

    if (screenFocus)
    {
        EventGroupHandle_t *lv_input_event = (EventGroupHandle_t *)param;
        xEventGroupSetBits(lv_input_event, LV_BUTTON);
        // xEventGroupSetBits(global_event_group, WAV_RING_1);
    }
    else
    {
        if (playing)
            writeDisplayCommand(CommandPlay);
        else
            writeDisplayCommand(CommandPause);

        playing = !playing;
    }
}

static void button_long_pressed()
{
    screenFocus = !screenFocus;
    if (screenFocus)
        lv_scr_load(ui_main_screen);
    else
        lv_scr_load(ui_rotary_screen);
}

/* Setup display, rotary encoder and button */
void lv_begin()
{
    /* Enable display */
    pinMode(PIN_LCD_POWER_ON, OUTPUT);
    digitalWrite(PIN_LCD_POWER_ON, HIGH); // Turn on the display enable pin

    /* Initialize rotary encoder button*/
    lv_input_event = xEventGroupCreate();
    button.attachClick(button_clicked, lv_input_event);
    button.attachLongPressStart(button_long_pressed);

    /* Initialize tft */
    tft.begin();
    tft.setRotation(3); /* Landscape orientation, flipped */
    tft.fillScreen(TFT_WHITE);

    /* Call before other lv functions */
    lv_init();

    /* Initialize the display buffer */
    static lv_disp_draw_buf_t draw_buf;
    static lv_color_t *buf1, *buf2;
    buf1 = (lv_color_t *)heap_caps_malloc(LV_BUF_SIZE * sizeof(lv_color_t), MALLOC_CAP_8BIT | MALLOC_CAP_SPIRAM);
    assert(buf1);
    buf2 = (lv_color_t *)heap_caps_malloc(LV_BUF_SIZE * sizeof(lv_color_t), MALLOC_CAP_8BIT | MALLOC_CAP_SPIRAM);
    assert(buf2);
    lv_disp_draw_buf_init(&draw_buf, buf1, buf2, LV_BUF_SIZE);

    /* Initialize the display */
    static lv_disp_drv_t disp_drv;
    lv_disp_drv_init(&disp_drv);
    disp_drv.hor_res = LV_SCREEN_WIDTH;
    disp_drv.ver_res = LV_SCREEN_HEIGHT;
    disp_drv.flush_cb = lv_disp_flush;
    disp_drv.draw_buf = &draw_buf;
    lv_disp_drv_register(&disp_drv);

    /* Initialize the rotary encoder */
    static lv_indev_drv_t indev_drv;
    lv_indev_drv_init(&indev_drv);
    indev_drv.type = LV_INDEV_TYPE_ENCODER;
    indev_drv.read_cb = lv_encoder_read;
    indev_drv.user_data = lv_input_event;

    /* Initialize the rotary input group */
    static lv_indev_t *lv_encoder_indev = lv_indev_drv_register(&indev_drv);
    lv_group_t *g = lv_group_create();
    lv_indev_set_group(lv_encoder_indev, g);
    lv_group_set_default(g);

    Serial.printf("Lvgl v%d.%d.%d initialized\n", lv_version_major(), lv_version_minor(), lv_version_patch());
}

/* Handles updating the display and encoder/button events */
void lv_handler()
{
    static uint32_t lastTick = 0;
    if (millis() - lastTick > 5)
    {
        lastTick = millis();
        lv_task_handler();
        button.tick();
        encoder.tick();
        encoder_read();
    }
}
