RileyCornelius/LedCube-RGB/(commit log)

2022-12-03 Add IO and Timer utlis
2022-12-05 Update Button, Timer, Animation and Cube
2022-12-23 Add benchmark begin and end defines to Timer
2022-12-23 Update Animator to no longer use a pointer array instead of a linked list
    [main.cpp]
2022-12-23 Update Cube class to support serpent led layout
2023-01-14 Fix serpentine layout algorithm
    [Cube.cpp, Cube.h, config.h]
2023-03-17 Add mechanical accessory files
    [BendBox Lid Flat.stl, BendBox Lid Thicker.stl, BendBox.stl, Clip.stl, Jig Bottom A.SLDPRT, Jig Bottom B.SLDPRT]
2023-03-17 Add mechanical case files
    [Assem1.SLDASM, Case Corner Power Hole.SLDPRT, Case Corner.SLDPRT, Case Corner.STL, Feet Small.SLDPRT, Feet.SLDPRT, LED Height 1x11 1-2x1-4inch.SLDPRT, Mounting Base.SLDPRT]
2023-03-17 Add electronics related files
    [LedCube.kicad_pcb, LedCube.kicad_sch, bom.xlsx]
2023-03-24 Add mounting holes to the case
    [Assem1.SLDASM, Case Corner.SLDPRT]
2023-03-31 Rename TowerTest firmware
    [Case Full.SLDPRT]
2023-03-31 Add T-Display-S3 driver project
2023-03-31 Add T-Embed driver project
2023-04-03 Add connectors to KiCad schematic
    [LedCube.kicad_sch]
2023-04-04 Add full case part
    [Assem Corner Case.SLDASM, Assem Full Case.SLDASM, Case Corner.SLDPRT, Case Full.SLDPRT]
2023-04-05 Add screen mount to case
    [Assem Full Case.SLDASM, Case Full.SLDPRT, Case Full2.SLDPRT, screen mount.SLDPRT, screen mount.STL]
2023-04-10 Add power cut out
    [Assem Full Case.SLDASM, Case Corner Power Hole.SLDPRT, Case Full.SLDPRT]
2023-04-15 Add power supply mounting brackets and fan cut out
    [Assem Full Case.SLDASM, Case Full.SLDPRT]
2023-04-15 Update kicad schematic
    [LedCube.kicad_pcb, LedCube.kicad_sch]
2023-04-16 Add simple message system between display and cube using uart
2023-04-18 Update to KiCad 7.0
    [LedCube.kicad_pcb, LedCube.kicad_sch]
2023-04-19 Add esp32 devkit footprint
    [LedCube.kicad_pcb, LedCube.kicad_sch]
2023-04-19 Create ESP32-DevkitM-1 footprint
    [LedCube.kicad_sch]
2023-04-20 Finish KiCad PCB board
    [LedCube.kicad_pcb, LedCube.kicad_sch]
2023-04-21 Generate PCB step file
    [LedCube.kicad_pcb, LedCube.step]
2023-04-22 Finish mechanical case design
    [Assem Corner Case.SLDASM, Assem Full Case.SLDASM, Assem Led Base.SLDASM, Assem Plexiglass .SLDASM, Case Corner Power Hole.SLDPRT, Case Corner.STL, Case Full.SLDPRT, Case Full2.SLDPRT]
2023-04-22 Generate case stl
    [Case Full.STL]
2023-04-22 Add over the air updates to LedCube firmware
2023-04-23 Update led pin defines
2023-04-28 Update kicad gerbers
    [LedCube.kicad_pcb, LedCube.kicad_sch, bom.csv]
2023-04-30 Fix play button display sync
    [main.cpp]
2023-04-30 Add Display functions to LedCube
2023-05-06 Replaced Button with SimpleButton class
    [main.cpp]
2023-05-06 Fix flipped vcc and gnd in KiCad
    [LedCube.kicad_pcb, LedCube.kicad_sch]
2023-05-21 Fix initial led clear
    [main.cpp]
2023-05-22 Fix ota progress display update
    [main.cpp, ui_events.cpp]
2023-05-22 Use rotary encoder to change animations
2023-05-22 Add rotary encoder page
2023-08-26 Rename variables and small fixes
    [Animations.h, Cube.cpp, Cube.h]
